cobra18t/CobraPin/README.md

# CobraPin
Pinball Controller based on OPP and designed for use with MPF

Visit https://pinballmakers.com/wiki/index.php?title=CobraPin for more information
