cobra18t/CobraPin/NeoSeg/NeoSeg14x2.PNG

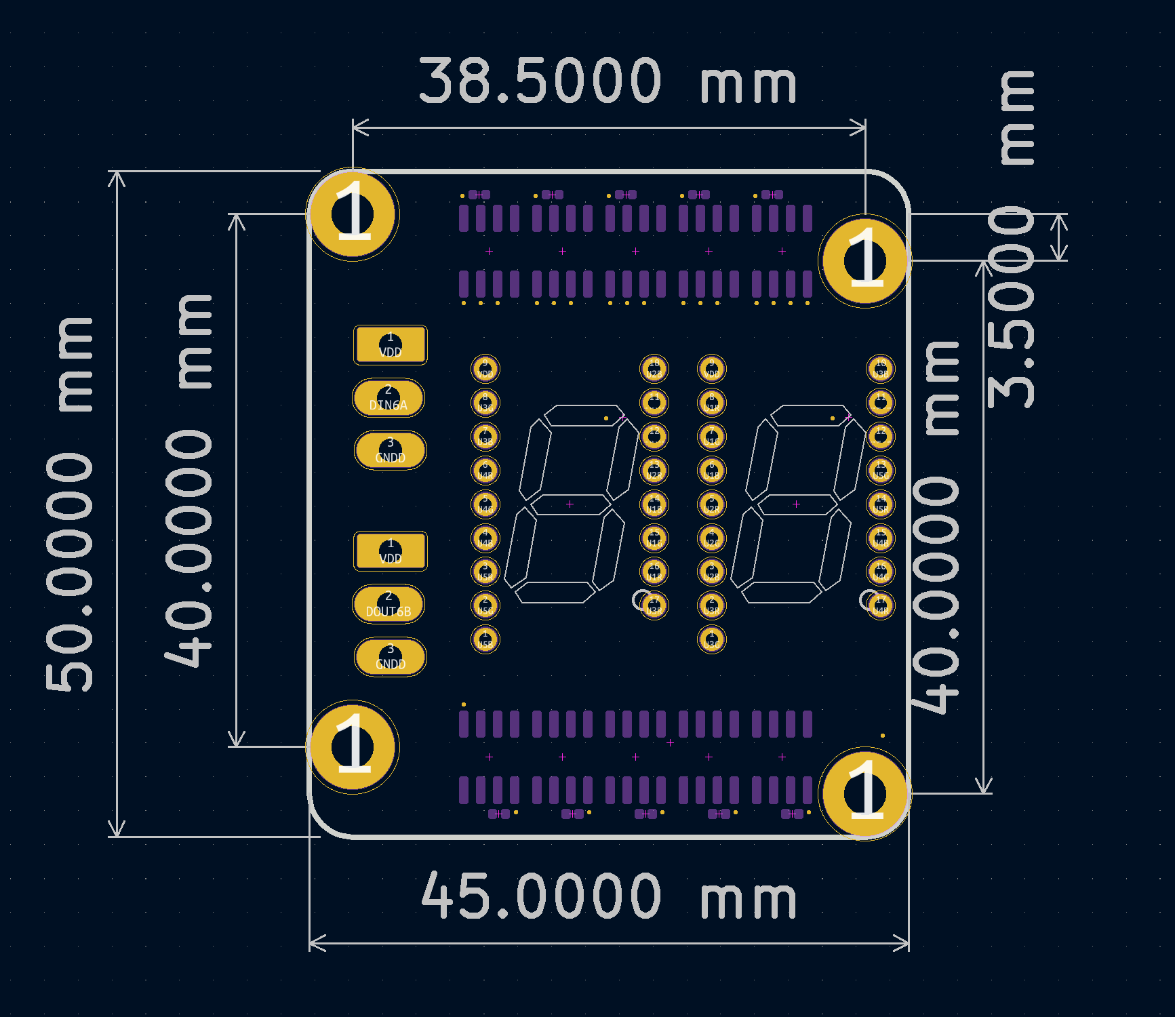
NeoSeg/NeoSeg14x2.PNG
