cobra18t/CobraPin/Games/MiniProto/target.3MF

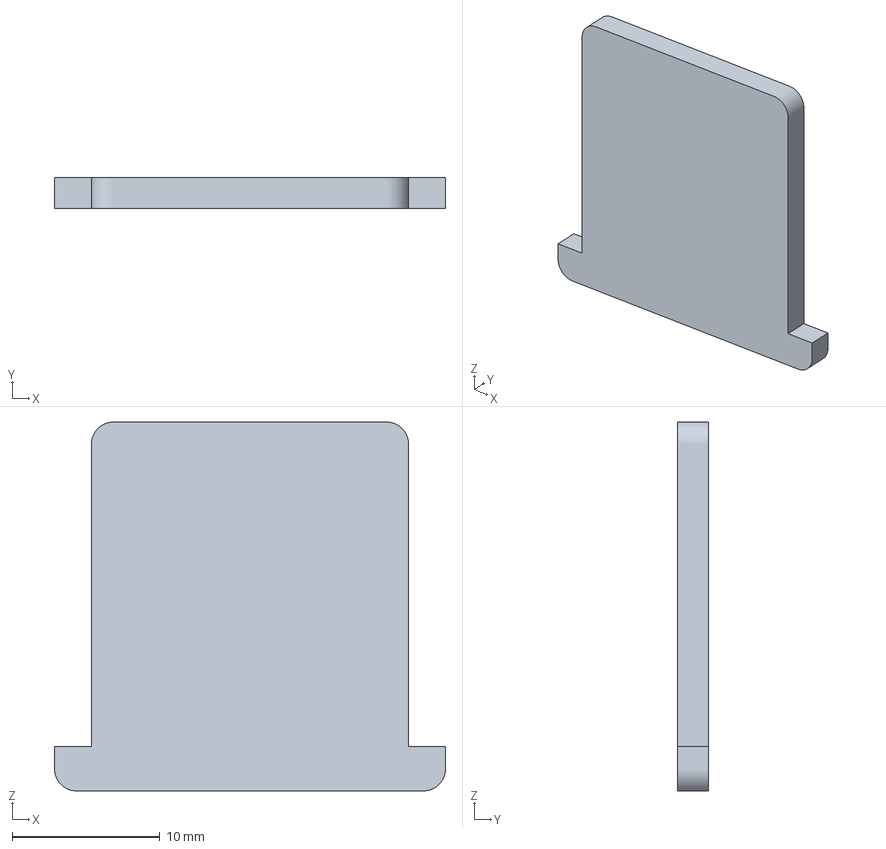
[picture p2: CAD file, 2026-05-30]
Games/MiniProto/target.3MF
26.5 x 2.10 x 25.0 mm
