cobra18t/CobraPin/Games/MiniProto/3bankTarget.3mf

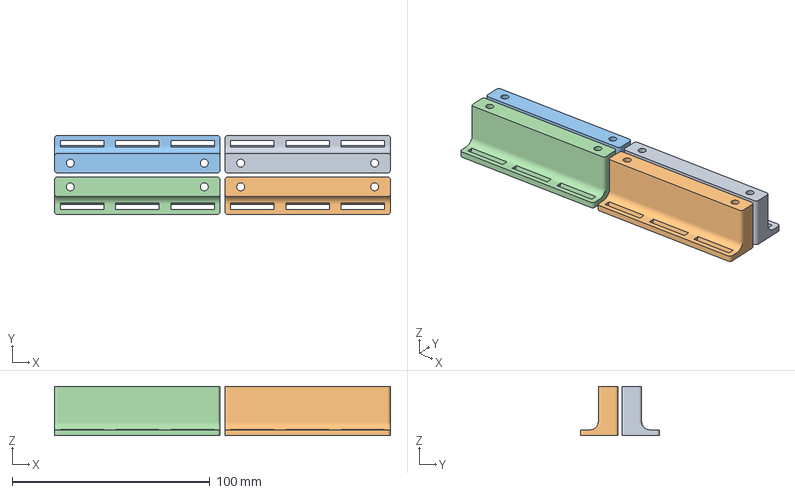
[picture p3: CAD file, 2026-05-30]
Games/MiniProto/3bankTarget.3mf
170.0 x 40.0 x 25.0 mm
3bankTarget x 4
