cobra18t/CobraPin/Games/MiniProto/TallTargetHolder.3MF

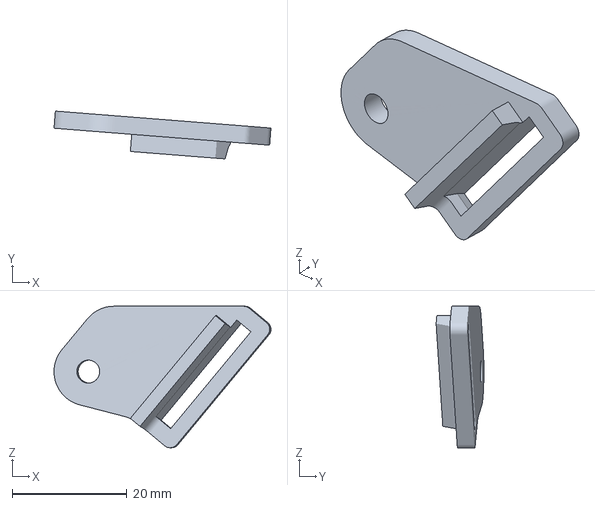
[picture p4: CAD file, 2026-05-30]
Games/MiniProto/TallTargetHolder.3MF
37.9 x 8.35 x 24.7 mm
