cobra18t/CobraPin/Games/MiniProto/drainGuidePickup.3mf

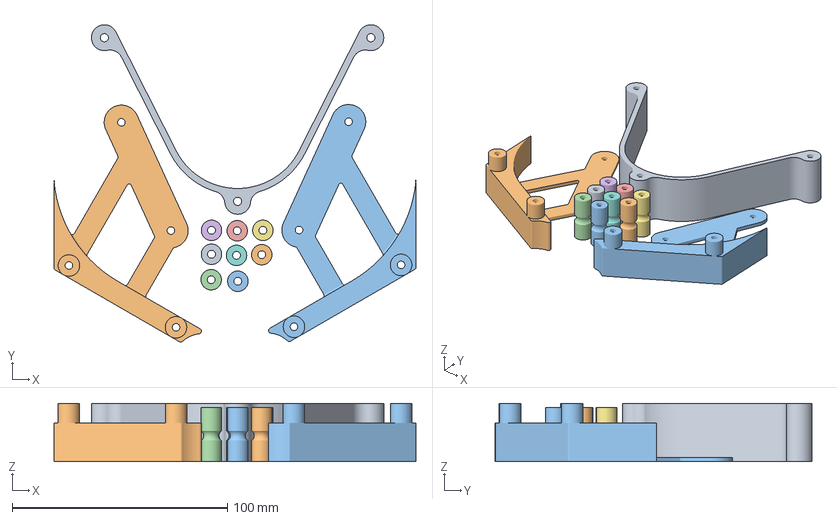
[picture p5: CAD file, 2026-05-30]
Games/MiniProto/drainGuidePickup.3mf
168.1 x 147.4 x 27.0 mm
drainGuidePickup
lower guide x 2
Post x 8
