cobra18t/CobraPin/Games/MiniProto/Post.3MF

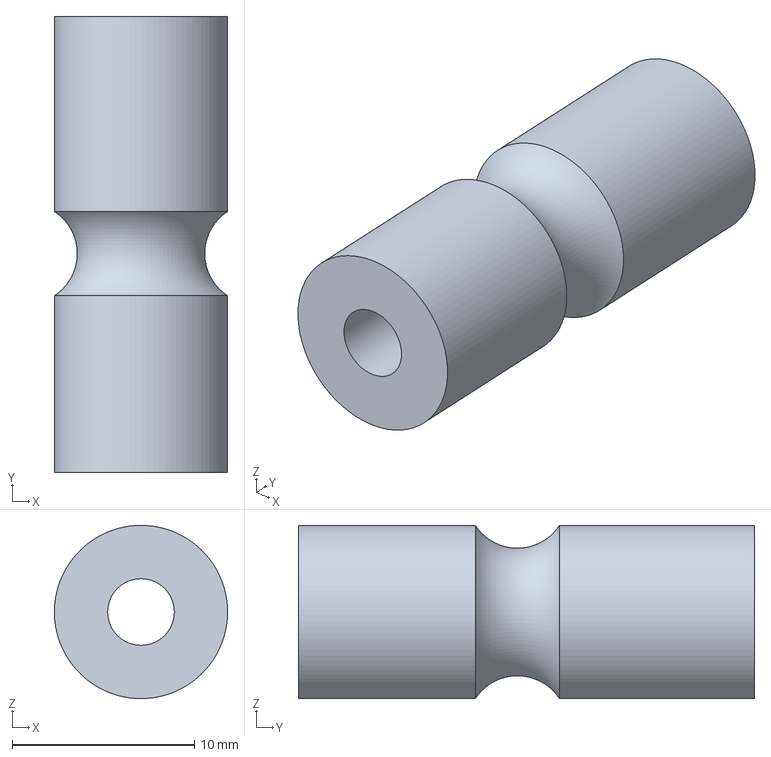
[picture p6: CAD file, 2026-05-30]
Games/MiniProto/Post.3MF
9.49 x 25.0 x 9.50 mm
