cobra18t/CobraPin/Games/MiniProto/targetTaller.3MF

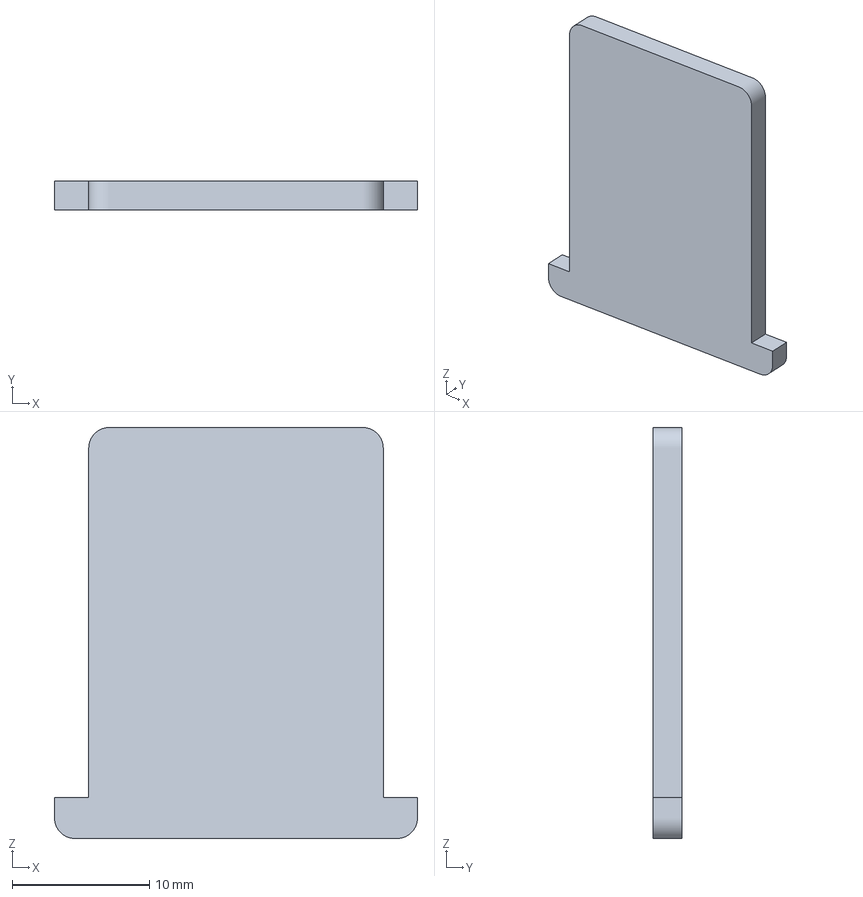
[picture p7: CAD file, 2026-05-30]
Games/MiniProto/targetTaller.3MF
26.5 x 2.10 x 30.0 mm
