cobra18t/CobraPin/Games/MiniProto/orbitAndLoop.3MF

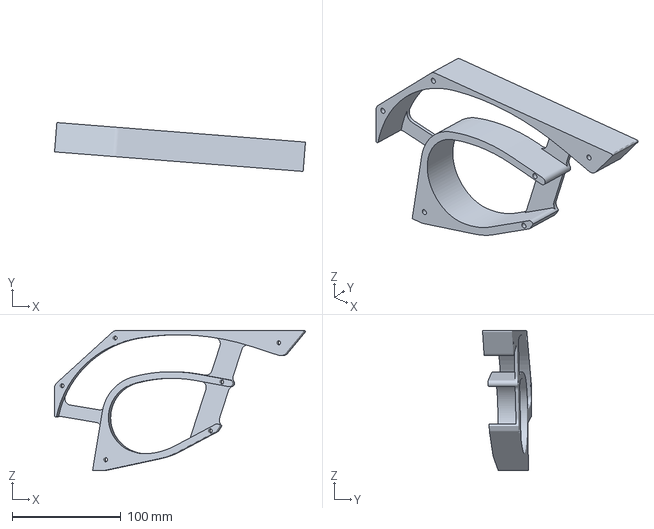
[picture p8: CAD file, 2026-05-30]
Games/MiniProto/orbitAndLoop.3MF
230.3 x 44.9 x 128.6 mm
