cobra18t/CobraPin/Games/MiniProto/MiniProto3_layout.DXF

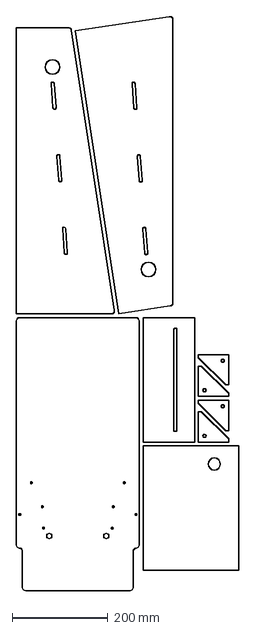
[picture p9: CAD file, 2026-05-30]
Games/MiniProto/MiniProto3_layout.DXF
465.2 x 1202.5 mm
