cobra18t/CobraPin/(threads)

Thread 2 (2022-10-03):

BOM & CPL files for Cobra-pin board

brovreizh, 2022-10-03:
Hello,

I've searched in the documents but I can not find any BOM & CPL files for Cobra-pin, is it normal ? Thx

cobra18t, 2022-10-04:
You can create the BOM and CPL files from the source KiCad files.

Closed 2022-10-04.

Thread 5 (2023-02-13):

Issue with Coil power output

worldpeace-germany, 2023-02-13:
Hi,

on testing flipper fingers some smoke came from the board :-( I would like to understand what went wrong to avoid this mistake in the future. I assume one of the transistors is burned.

Question 1:
The documentation says the max fuse used for the coil power should be 10A. I used one of the 10A fuses. After the issue the fuse is still okay.  Aren't the transistors rated for 10A that they burn? My understanding here is that the fuse should protect the electric components, why is it not?

Question 2:
The output in question (main coil, not hold coil) shows now constantly 24V as output (I am using for my test 24V power supply). Based on that I assume that my transistor is dead for that output. The strange thing is the yellow LED indicating that the transistor is switching is behaving like one for a fully working output. Which means it is off all the time unless I press my trigger button then it is turned on. Either I misunderstood a detail of that yellow LED or the transistor is still okay, but then I should not see constantly 24V on the output. Can that behavior be explained?

Question 3:
At the moment I have no idea how it came to the situation. The  mpf code is basically from the tutorial. So the main coil is only powered for a few ms (default value, I assume 10ms) and the hold coil powered constantly (while keeping the button pressed). The coil is a FL-11629-50V coil, I measured 3.5 Ohm and 135 Ohm of resistance. Which would mean for 24V power supply 6.9A and 170mA. I had a look at https://flippers.com/coil-resistance.html , they say 4/133 Ohm, so no big difference. In the text they say "blue, strongest", the paper wrapping of mine is orange which would be according to their chart a FL-15411 coil with 4.2/150 Ohm. Again no big difference to what I measured. Any idea what mistake I could have made? Would like to avoid killing more outputs....

Thanks!

worldpeace-germany, 2023-02-13:
Okay, found my mistake, I had a short connection on the coil when the switch was pressed. That answers question 3. Question 1 and 2 remain valid. I don't mind too much for now if I have one coil output less, the price you pay when learning new things. Any guess on what I might have fried up?

cobra18t, 2023-02-13:
Re Q1:
The fuses are slow blow fuses. They can actually withstand far more than 10A for a very short amount of time. The transistor can only handle maybe 40A but burns out instantly above that. Since you had a hard short, you had far too much current at once and the transistor burned. It was short enough pulse, though that the fuse survived. I would evaluate your current draws on that bank and consider a lower fuse current. Many people add inline fuses to each flipper.

Re Q2: The yellow LEDs are on the logic side of the FET. They indicate the *Command* to the FET, not the *Output* of the FET. So even though the FET is broken, you can see the command is fine. This enables you to evaluate proper operation on the logic side before applying coil power. I believe your FET is broken.

worldpeace-germany, 2023-02-14:
thanks, understood. then one day I will change the FET.

Closed 2023-02-14.

Thread 6 (2023-04-05):

Seek guidance to size power supply

worldpeace-germany, 2023-04-05:
Hello,

I seek some guidance what is the right size (wattage) of the power supply to choose. I neither want to buy a crazy big power supply, neither it should not have too little wattage that I start buying a second one in half a year.

My considerations are the following:

- Voltage: 48V
- 3 coils in parallel to be fired at max simultaneously (2 flipper fingers plus one sling shot, bumper, etc)
- Coils 26-1200 (10 Ohm), 23-800 ( 4 Ohm) for bumpers, etc.
- FL-11629 (4 Ohm) for flipper fingers

I have no clue yet if the coils for 48V are a good choice, chicken and egg problem. Should be just a "normal" or "average" coil for these purposes.

A 4 Ohm coil would draw 12A, if I have three of them at the same time it is 36A, if the 10 Ohm coil is good for my purpose I have 2*12A + 5A = 29A of electrical current. That would be 1400 - 1800 W - I cannot believe that I need that. Of course current will only be drawn for 20-40ms and we have the large capacitors on the cobra board to buffer. I have no idea how to factor that into my thoughts.

Any guidance, what coils would be good, how to come to a reasonable (and somewhat reliable) result?

About the coils, anything I need to obey that I don't fry a mos-fet on the cobra board?

How powerful are the power supplies of the people reading this?

Thanks!

cobra18t, 2023-04-06:
I have a 48V 7.5A supply. A 10 or 12A would be fine as well. The average load is not actually that high, it is just very spiky. The capacitors help supply those load spikes.

A 4ohm coil should not really draw 12A for even 20-40ms. Remember, the coil acts like an inductor which resists instantaneous changes to current. So if you left the coil on, sure it would get to a 12A draw eventually, but the pulse is over or at least nearly over before then. If you do reach 12A for any appreciable amount of time, you should be blowing fuses.

In the image below, the current never reaches steady state current since the pulse ends before the inductor charges all the way. I have not actually measured the current waveform of these particular coils, though. In the end, a 7.5 to 12A supply "just works" for pinball.

As far as not frying FETs, triple check your pinout and note that each connector has 8 coil outputs but 9 pins. One is a "key" pin that is in a different location on each bank. The key is marked by an asterisk.

Also, coil diodes must always "point" to power. So the cathode must always face the high voltage side. If you get this wrong, you will short 48V to GND through a forward biased diode when you first fire that coil which will surely fry the FET.

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

cobra18t, 2023-04-06:
As far as flipper coils, here is the common guidance:

FL-11753 (Yellow)- Used with short flippers and close shots....think Twilight Zone 2" upper flipper
FL-11722 (Green) - Used for close shots near drop targets...think Twilight Zone 3" upper flipper
FL-11630 (Red) - The standard, most commonly used coil...F-14 main flippers
FL-15411 (Orange) - Used for long playfield shots...Twilight Zone main flippers
FL-11629 (Blue) - Used for long shots and high ramps...Demolition Man main flippers

If you have the latest OPP firmware (2.4.0.0 or later is recommended), you can change the pulse power through MPF to reduce the power of a flipper to tune it. That is what I am doing on my Tag Team.

worldpeace-germany, 2023-04-08:
As usual a perfect answer in no time at all. Thanks very much!

Closed 2023-04-08.

Thread 7 (2023-07-25):

Input Switches min/max resistance

worldpeace-germany, 2023-07-25:
Hi,

a short question, when I want to to use a direct input switch. So far I have closed the switch just by connecting the input pin to GND, so 0 Ohm between input and GND. I assume that internally there is some resistor that it is not a short circuit. So far nothing blew up, can you confirm that this is okay to do?

Now the more important question,  what is the maximum resistance that the the switch is being considered as closed? I assume if I connect the input to GND via 100 Megaohm that this is not recognized as closed. Background of the question is photo diode, if I shine IR light on it, it has a resistance of 180 Ohm. Is that just a limit where it sometimes will work and sometimes not? What is a  safe maximum for a resistor so the switch is reliably considered as closed?

Thanks!

cobra18t, 2023-07-25:
The input pins are pulled up internally with a ~30k ohm resistor, so shorting that to GND is no issue.

A pure resistance analysis of the photodiode is insufficient. Since the matrix is rapidly scanning/pulsing through the columns, capacitance becomes a big player and photodiodes have a fair bit of capacitance.

Are you noticing inconsistencies in the switch performance using the photodiode? When using optos, I usually recommend using the external row pullups on the board to overcome the capacitive effect of the optos. Your photodiode may benefit from the same treatment. https://pinballmakers.com/wiki/index.php?title=CobraPin#Matrix_Row_Pull_Resistor_Jumpers

worldpeace-germany, 2023-07-27:
Hello,

it seems to work, but maybe there is a restriction once I have more switches, whatsoever. It is just a fear I had and would like to be on the right path from the beginning. I saw the note on the pull resistor for the matrix switch, I am using direct input. I have some basic knowledge on electronics (and try to expand), but I am not able to judge if the part is valid as well for direct input switches. Since it was mentioned in the matrix section I decided not to be relevant. If it is, do I need pull up or down?

cobra18t, 2023-07-27:
Ah, direct inputs should be fine. No need for the pull resistors.

Closed 2025-06-28.

Thread 8 (2025-06-27):

Kicad files for Xpansion board

VLanvin, 2025-06-27:
Hey there!

Any chance you could add the kicad files for the Xpansion board? I'd like to drive both neopixels and 12V lights.

Thanks!

cobra18t, 2025-06-28:
Source added to the KiCad folder. The Xpansion board does not drive Neopixels, just to be clear. The lamp supply voltage should be around 18V for normal pinball bulbs (https://pinballmakers.com/wiki/index.php?title=CobraPin#Power_Input_2).

Closed 2025-06-28.
