cobra18t/CobraPin/KiCad/CobraPin_Xpansion.pdf

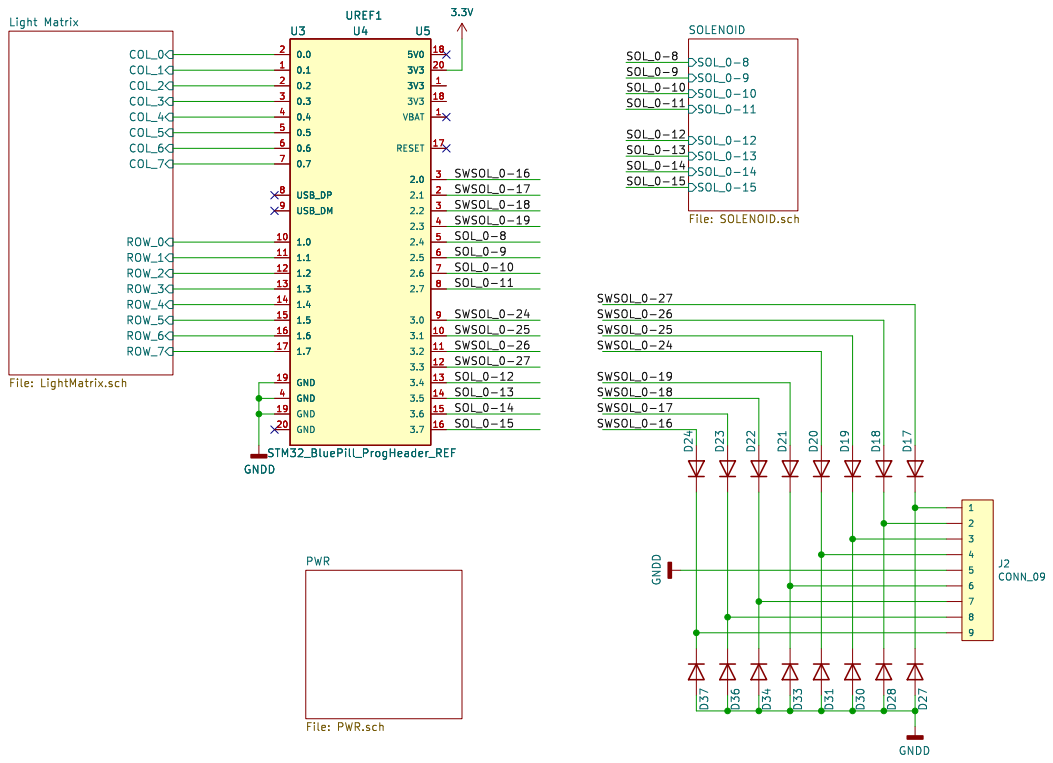
[picture p10: page 1]

Id: 1/4 Title: File: CobraPin_Xpansion.sch Sheet: / PWR

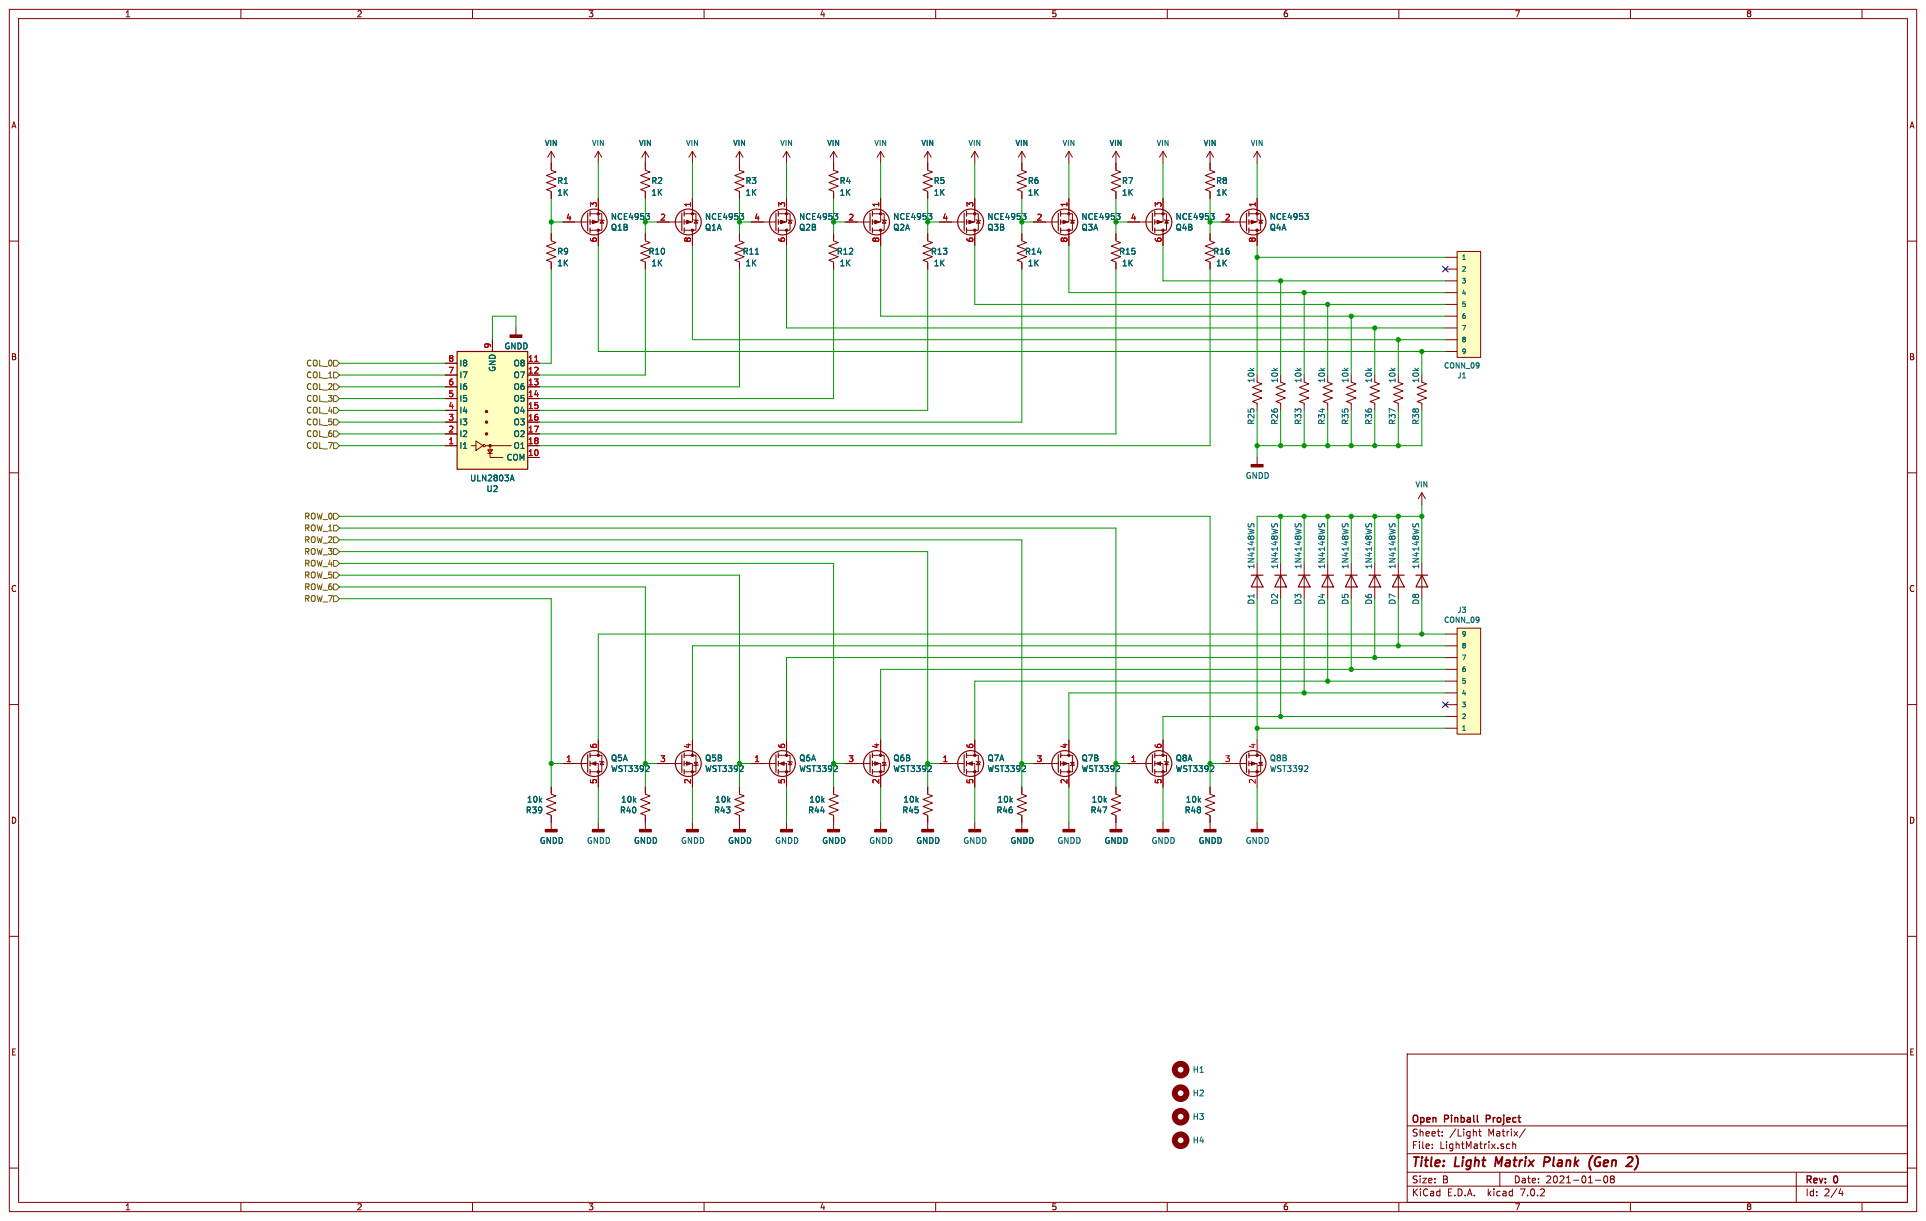
[picture p11: page 2]

5 6 Q7A WST3392 GNDD GNDD GNDD GNDD

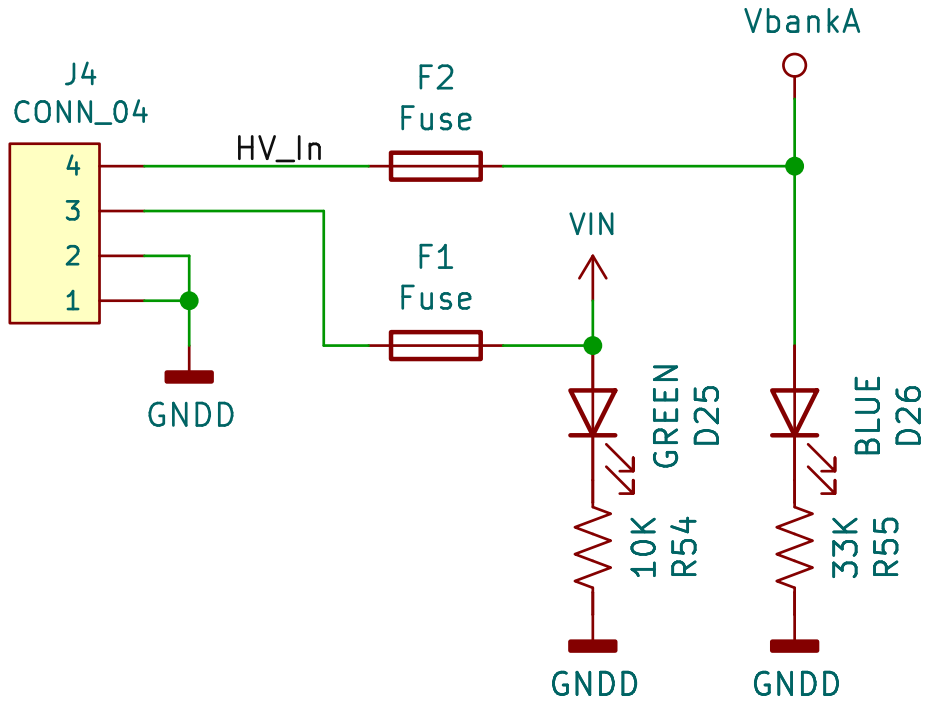
[picture p12: page 3]

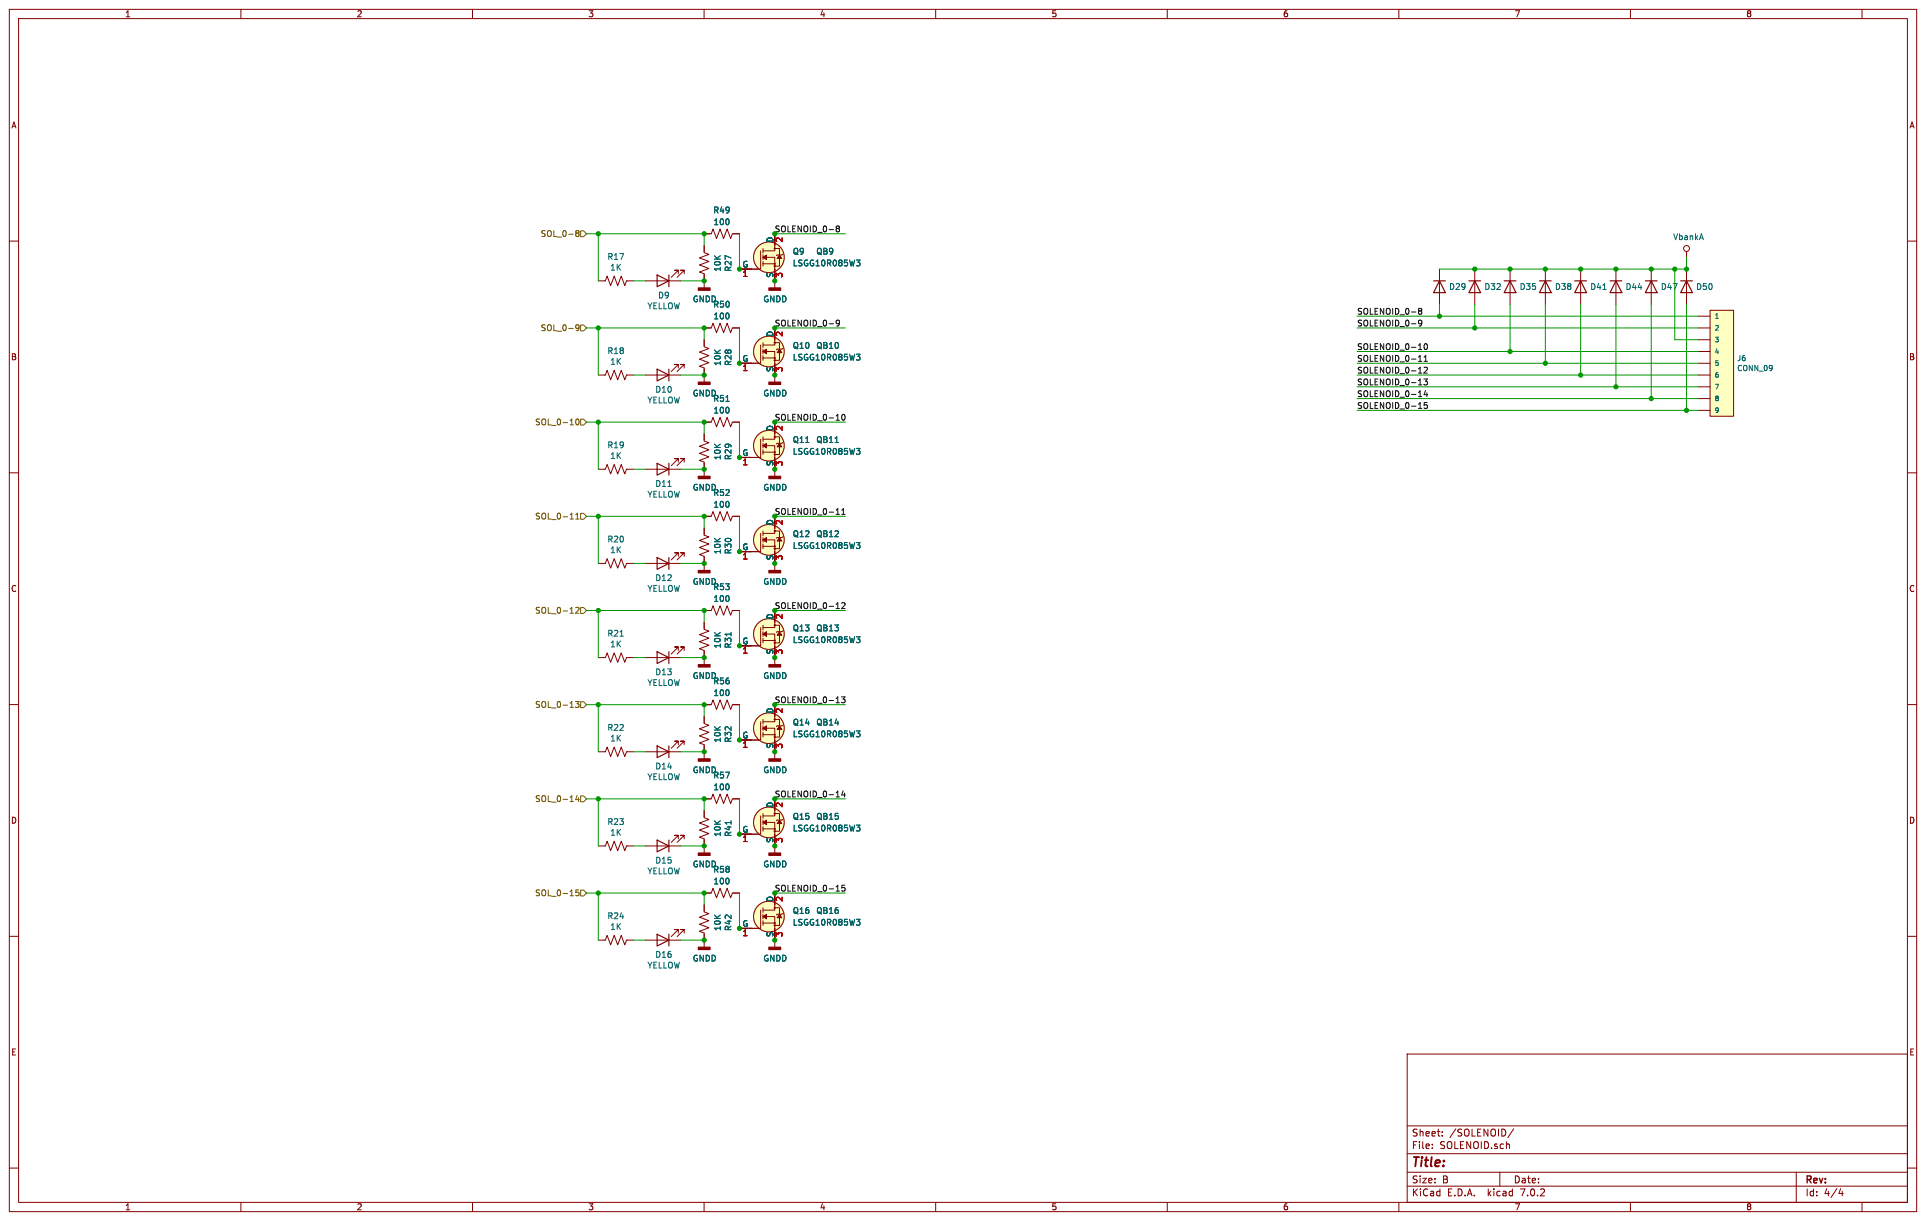
[picture p13: page 4]

Id: 4/4 Title: File: SOLENOID.sch Sheet: /SOLENOID/
