cobra18t/CobraPin/KiCad/CobraPin_v1_03.pdf

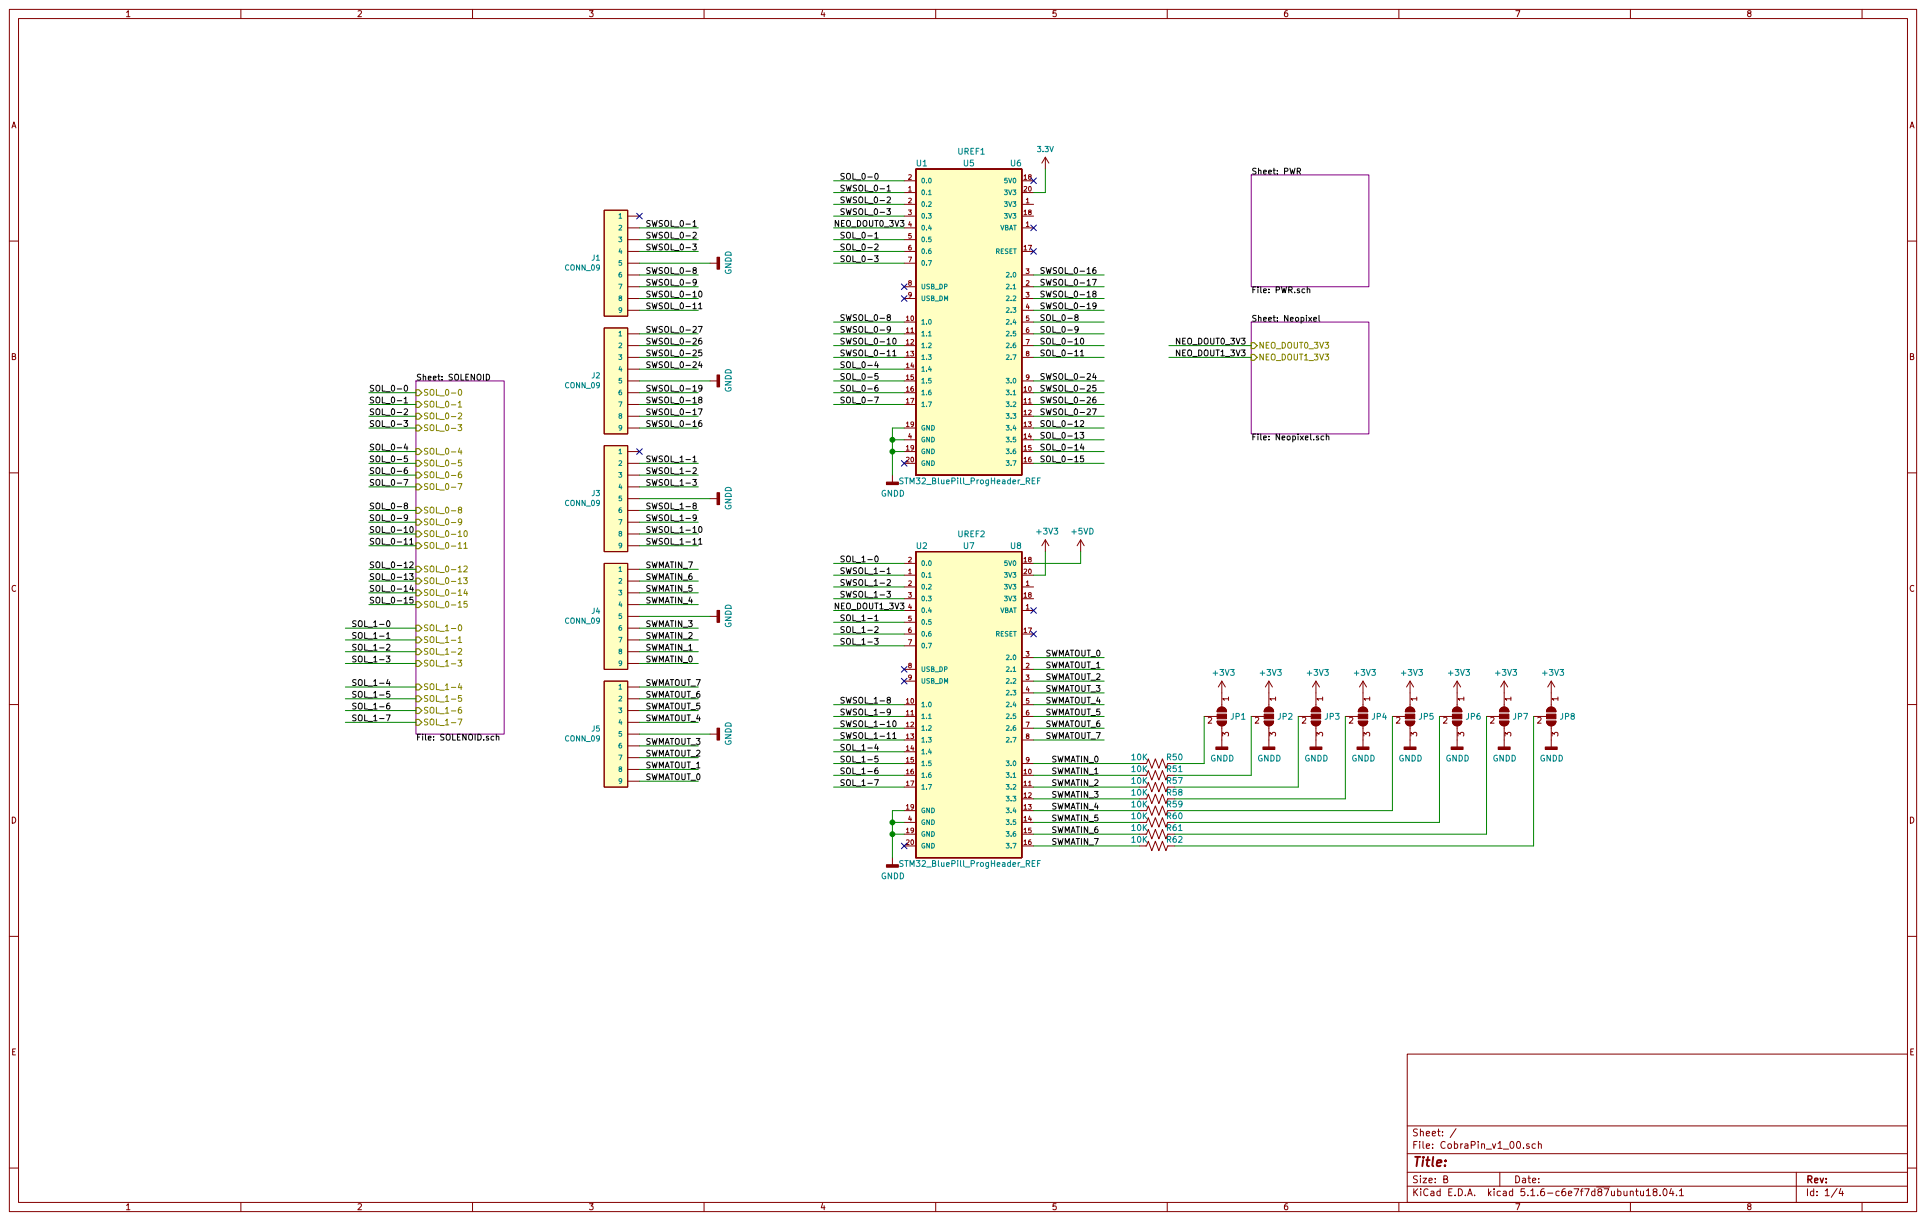
[picture p14: page 1]

File: PWR.sch Sheet: Neopixel

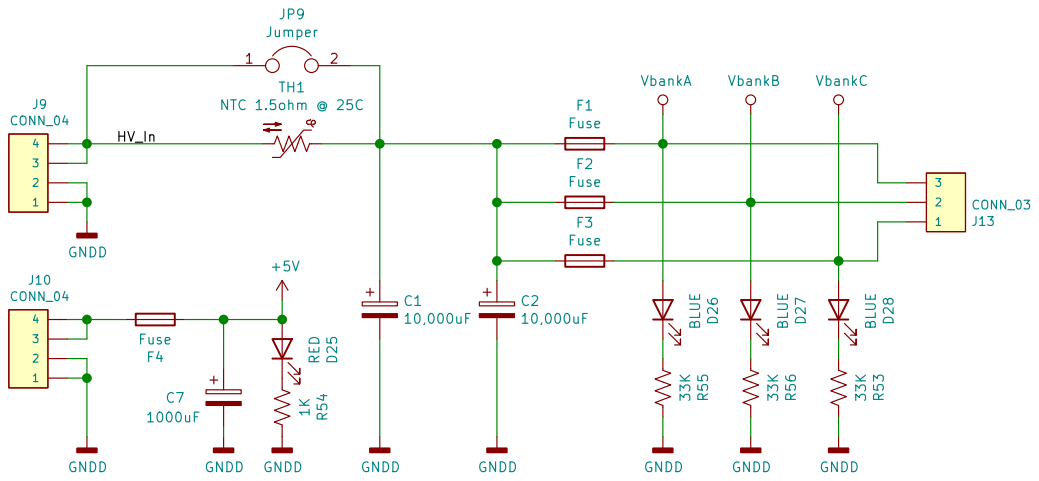
[picture p15: page 2]

Id: 2/4 Title: File: PWR.sch Sheet: /PWR/ D28 BLUE

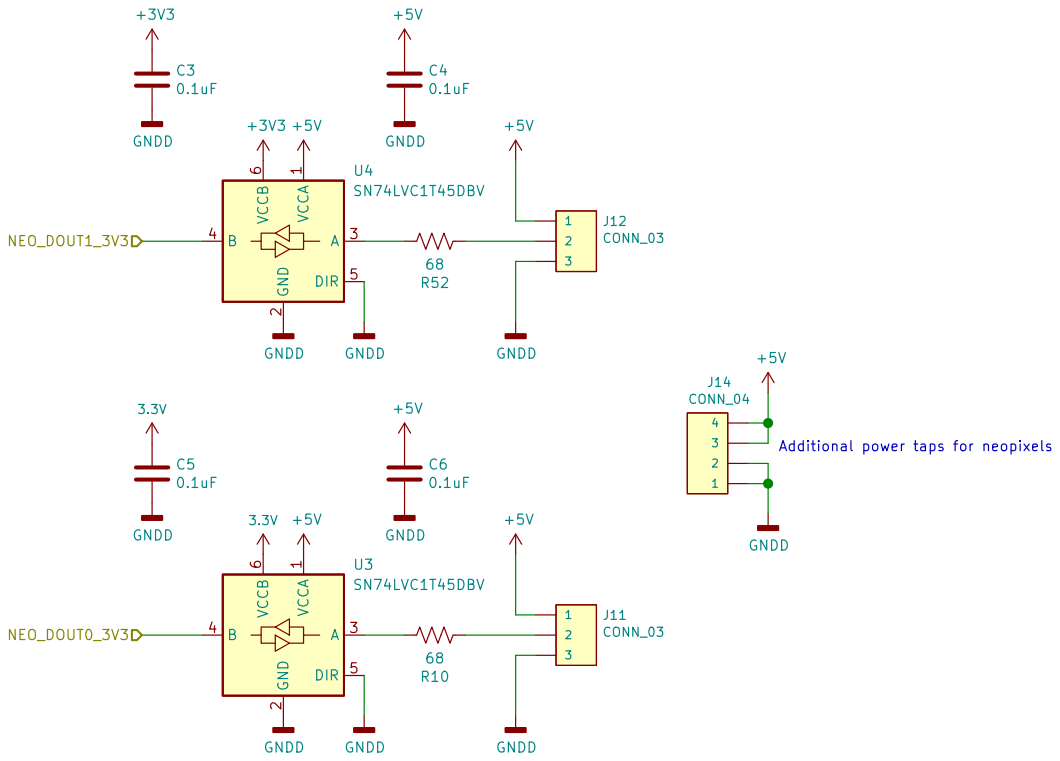
[picture p16: page 3]

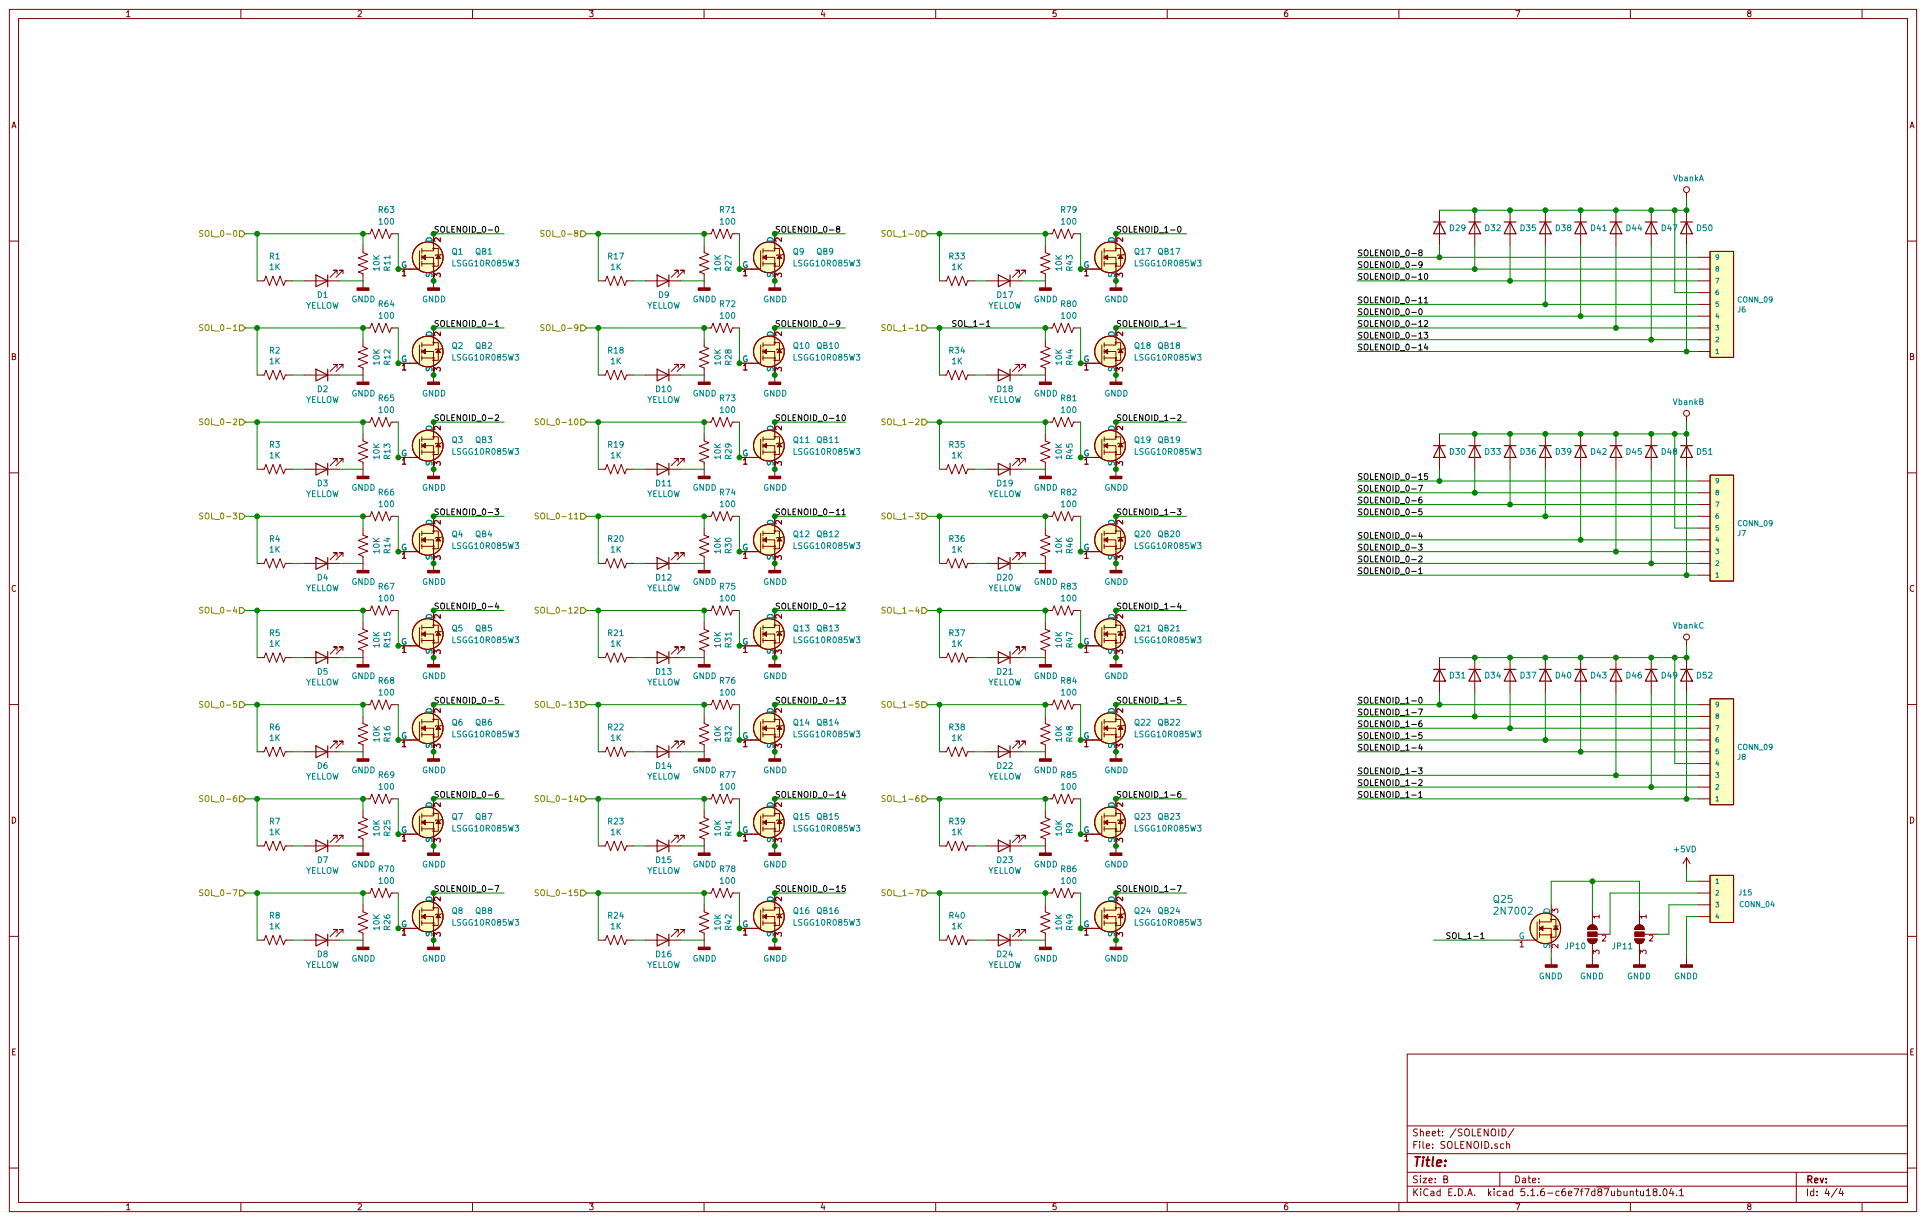
[picture p17: page 4]

Id: 4/4 Title: File: SOLENOID.sch Sheet: /SOLENOID/
