cobra18t/CobraPin/Errata/CobraPin J4_J5 Relabel.pdf

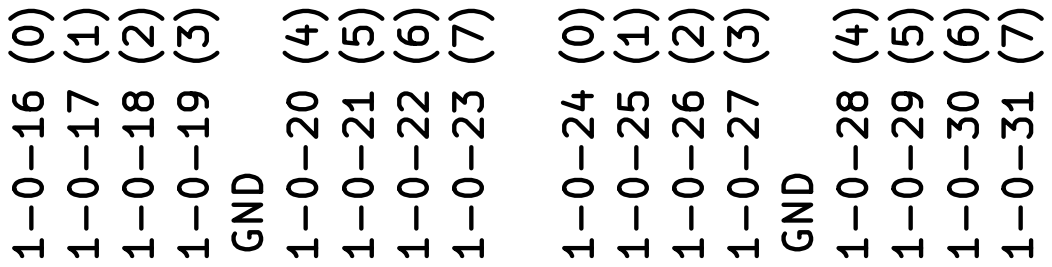
[picture p18: page 1]
