cobra18t/CobraPin/KiCad/Satellite_boardDimensions.pdf

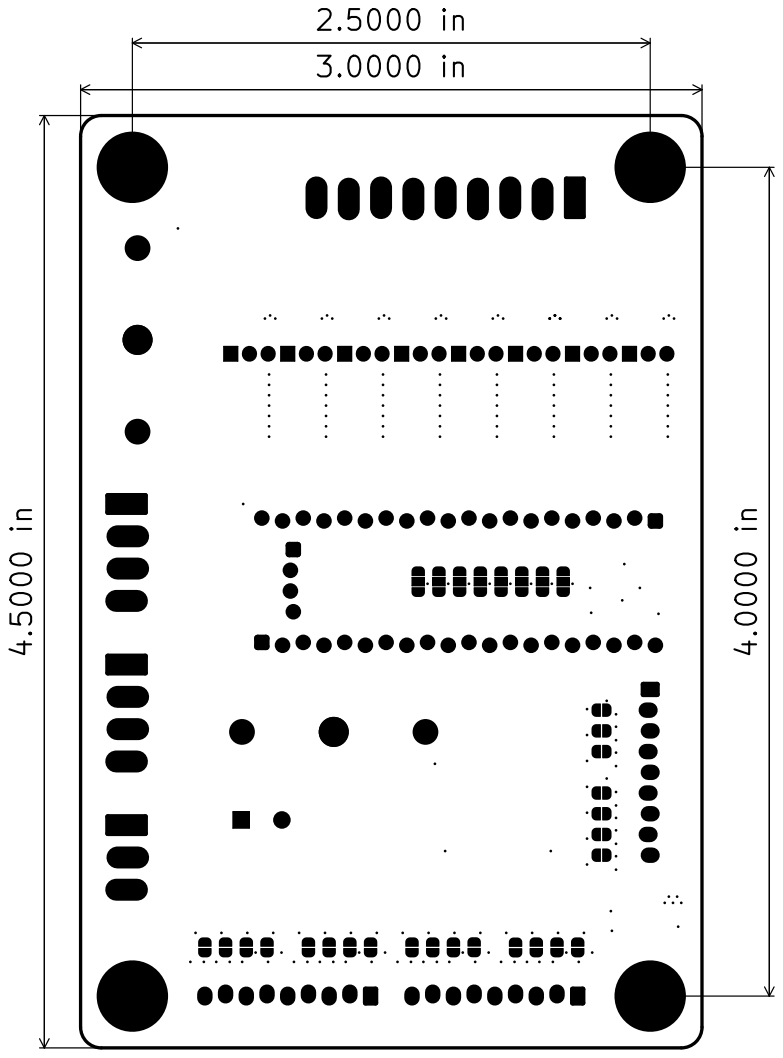
[picture p19: page 1]
