cobra18t/CobraPin/NeoSeg/NeoSeg14 8-Digit.pdf

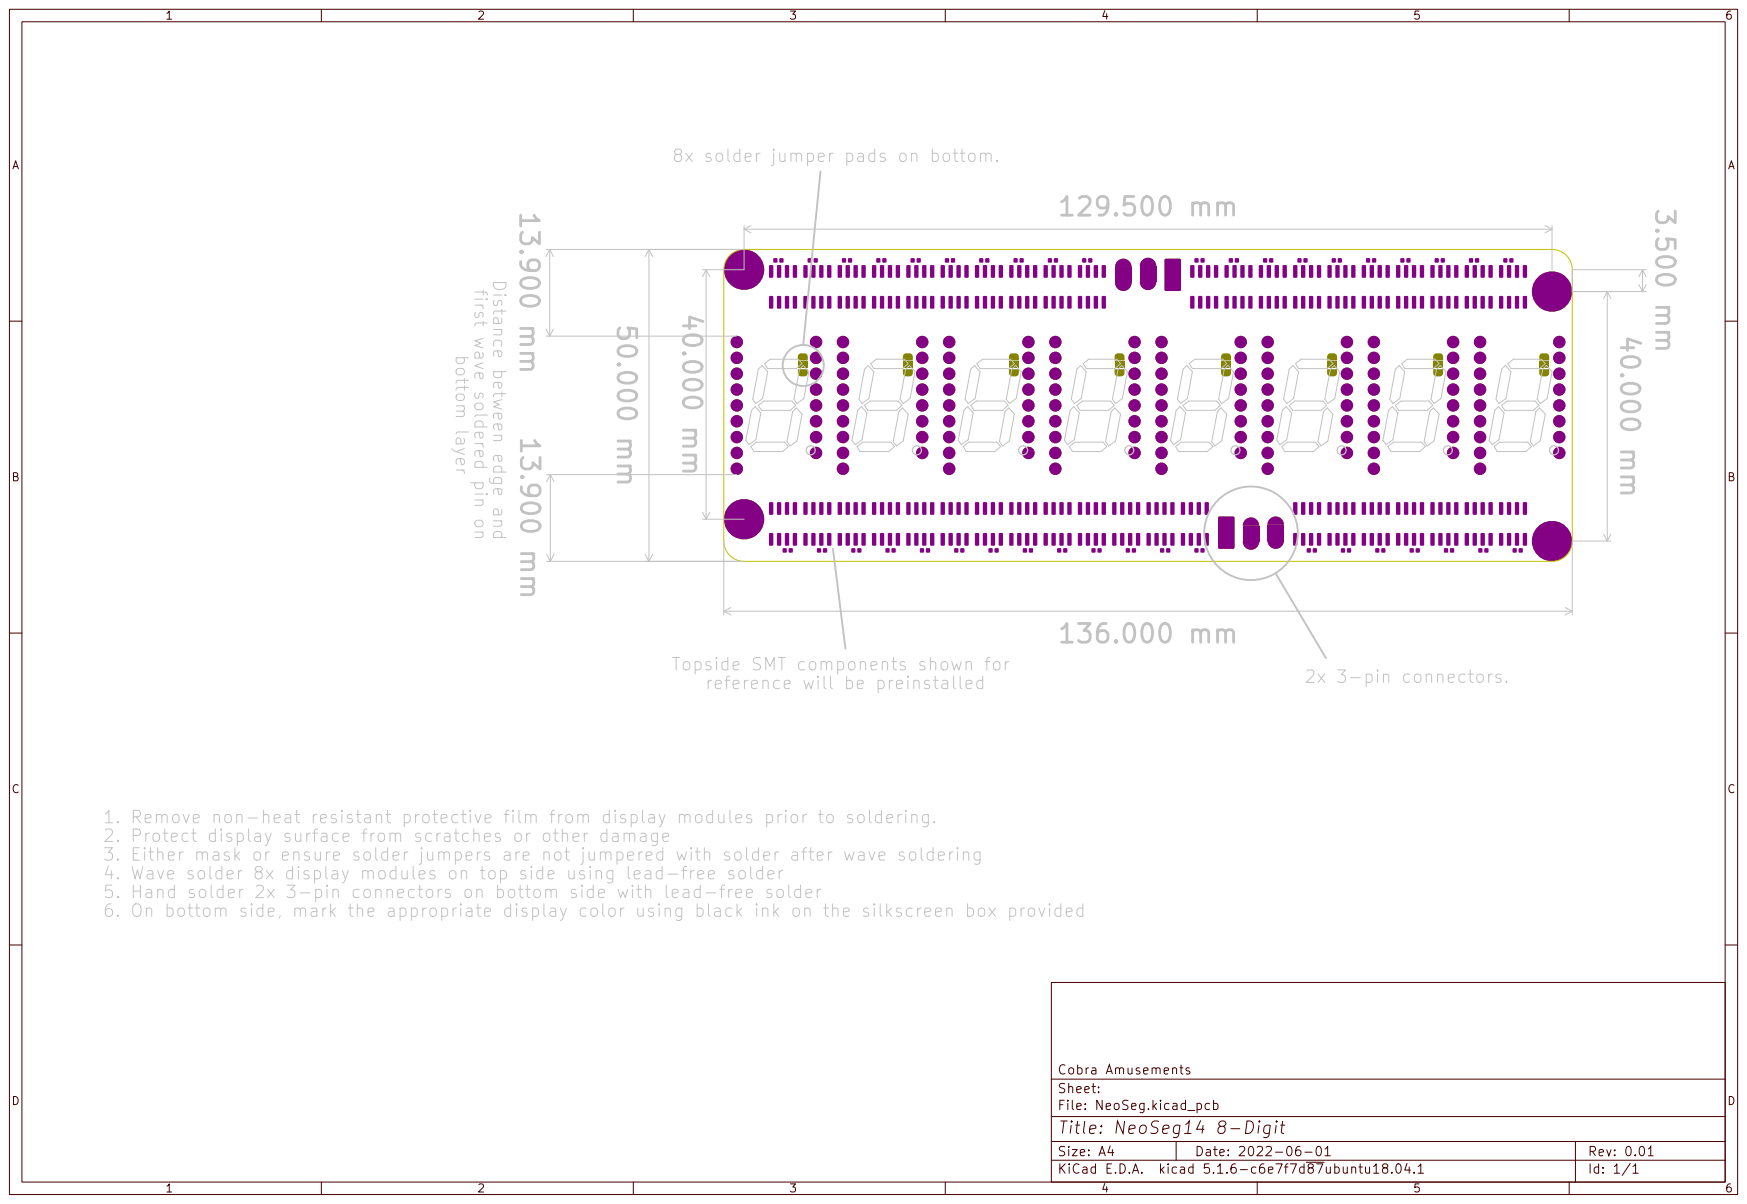
[picture p20: page 1]
