cobra18t/CobraPin/KiCad/CobraPin_v1_00.kicad_pcb

## KiCad design KiCad/CobraPin_v1_00.kicad_pcb (2021-08-28)

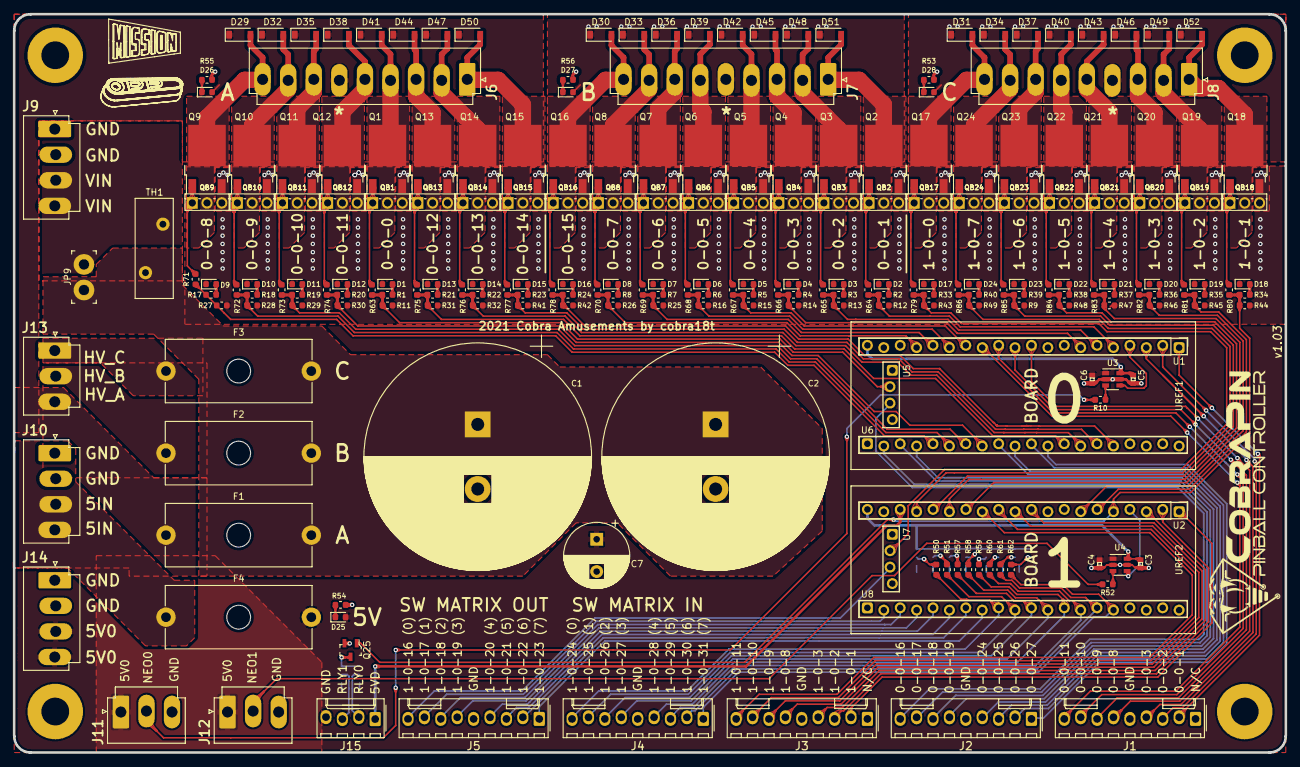
[picture p21: board CobraPin_v1_00.kicad_pcb from above]

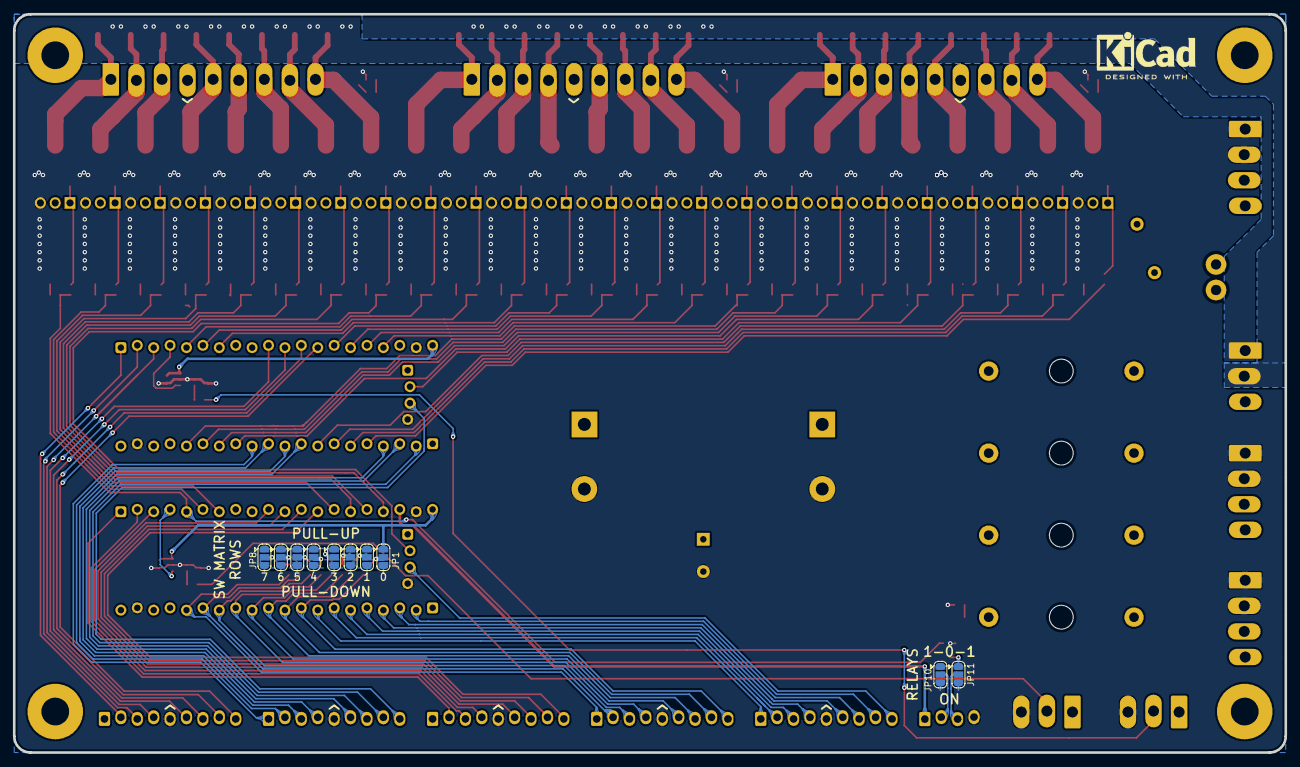
[picture p22: board CobraPin_v1_00.kicad_pcb from below]

Board: 2 copper layers, 196.9 x 114.3 mm, 235 parts (10 on the bottom side), 166 nets.

Parts:
C1, C2: 10,000uF; CP_Radial_D35.0mm_P10.00mm_SnapIn
C3, C4, C5, C6: 0.1uF; 0402
C7: 1000uF; CP_Radial_D10.0mm_P5.00mm
D1, D2, D3, D4, D5, D6, D7, D8, D9, D10, D11, D12, D13, D14, D15, D16, D17, D18, D19, D20, D21, D22, D23, D24: YELLOW; LED_0603_1608Metric
D25: RED; LED_0603_1608Metric
D26, D27, D28: BLUE; LED_0603_1608Metric
D29, D30, D31, D32, D33, D34, D35, D36, D37, D38, D39, D40, D41, D42, D43, D44, D45, D46, D47, D48, D49, D50, D51, D52: 1A 1000V; D_SOD-123
F1, F2, F3, F4: Fuse; Fuseholder_Cylinder-5x20mm_Schurter_0031_8201_Horizontal_Op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
J1, J2, J3, J4, J5: CONN_09; Molex_KK-254_AE-6410-09A_1x09_P2.54mm_Vertical_Lock
J6, J7, J8: CONN_09; JST_VH_B9P-VH_1x09_P3.96mm_Vertical_LongPads_Lock
J9, J10, J14: CONN_04; JST_VH_B4P-VH_1x04_P3.96mm_Vertical_LongPads_Lock
J11, J12, J13: CONN_03; JST_VH_B3P-VH_1x03_P3.96mm_Vertical_LongPads_Lock
J15: CONN_04; Molex_KK-254_AE-6410-09A_1x04_P2.54mm_Vertical_Lock
JP1, JP2, JP3, JP4, JP5, JP6, JP7, JP8, JP10, JP11: SolderJumper_3_Open; SolderJumper-3_P1.3mm_Open_RoundedPad1.0x1.5mm
JP9: Jumper; PinHeader_1x2_P3.96mm_Drill1.6mm_TEF
Q1, Q2, Q3, Q4, Q5, Q6, Q7, Q8, Q9, Q10, Q11, Q12, Q13, Q14, Q15, Q16, Q17, Q18, Q19, Q20, Q21, Q22, Q23, Q24: LSGG10R085W3; TO-252-2
Q25: 2N7002; SOT-23-3
QB1, QB2, QB3, QB4, QB5, QB6, QB7, QB8, QB9, QB10, QB11, QB12, QB13, QB14, QB15, QB16, QB17, QB18, QB19, QB20, QB21, QB22, QB23, QB24: TO251; TO-251-3_Vertical
R1, R2, R3, R4, R5, R6, R7, R8, R17, R18, R19, R20, R21, R22, R23, R24, R33, R34, R35, R36, R37, R38, R39, R40, R54: 1K; R_0603_1608Metric
R9, R11, R12, R13, R14, R15, R16, R25, R26, R27, R28, R29, R30, R31, R32, R41, R42, R43, R44, R45, R46, R47, R48, R49, R50, R51, R57, R58, R59, R60, R61, R62: 10K; R_0603_1608Metric
R10, R52: 68; R_0603_1608Metric
R53, R55, R56: 33K; R_0603_1608Metric
R63, R64, R65, R66, R67, R68, R69, R70, R71, R72, R73, R74, R75, R76, R77, R78, R79, R80, R81, R82, R83, R84, R85, R86: 100; R_0603_1608Metric
TH1: NTC 1.5ohm @ 25C; RV_Disc_D15.5mm_W5.9mm_P7.5mm_TEF
U1, U2: STM32_BluePill_ProgHeader_Separate_A; 1x20_FEMALE_LOCK
U3, U4: SN74LVC1T45DBV; SOT-23-6
U5, U7: STM32_BluePill_ProgHeader_Separate_B; 1x04_FEMALE_LOCK
U6, U8: STM32_BluePill_ProgHeader_Separate_C; 1x20_FEMALE_LOCK
UREF1, UREF2: STM32_BluePill_ProgHeader_REF

Connections:
3.3V: C5.1, U1.20, U3.6
+3V3: C3.1, JP1.1, JP2.1, JP3.1, JP4.1, JP5.1, JP6.1, JP7.1, JP8.1, U2.20, U4.6
+5V: C4.1, C6.1, C7.1, D25.2, F4.2, J11.1, J12.1, J14.3, J14.4, U3.1, U4.1
+5VD: J15.1, U2.18
/NEO_DOUT0_3V3: U1.4, U3.4
/NEO_DOUT1_3V3: U2.4, U4.4
/PWR/HV_In: J9.3, J9.4, JP9.1, TH1.2
/SOLENOID/SOLENOID_0-0: D41.2, J6.4, Q1.2, QB1.2
/SOLENOID/SOLENOID_0-1: D51.2, J7.1, Q2.2, QB2.2
/SOLENOID/SOLENOID_0-2: D48.2, J7.2, Q3.2, QB3.2
/SOLENOID/SOLENOID_0-3: D45.2, J7.3, Q4.2, QB4.2
/SOLENOID/SOLENOID_0-4: D42.2, J7.4, Q5.2, QB5.2
/SOLENOID/SOLENOID_0-5: D39.2, J7.6, Q6.2, QB6.2
/SOLENOID/SOLENOID_0-6: D36.2, J7.7, Q7.2, QB7.2
/SOLENOID/SOLENOID_0-7: D33.2, J7.8, Q8.2, QB8.2
/SOLENOID/SOLENOID_0-8: D29.2, J6.9, Q9.2, QB9.2
/SOLENOID/SOLENOID_0-9: D32.2, J6.8, Q10.2, QB10.2
/SOLENOID/SOLENOID_0-10: D35.2, J6.7, Q11.2, QB11.2
/SOLENOID/SOLENOID_0-11: D38.2, J6.5, Q12.2, QB12.2
/SOLENOID/SOLENOID_0-12: D44.2, J6.3, Q13.2, QB13.2
/SOLENOID/SOLENOID_0-13: D47.2, J6.2, Q14.2, QB14.2
/SOLENOID/SOLENOID_0-14: D50.2, J6.1, Q15.2, QB15.2
/SOLENOID/SOLENOID_0-15: D30.2, J7.9, Q16.2, QB16.2
/SOLENOID/SOLENOID_1-0: D31.2, J8.9, Q17.2, QB17.2
/SOLENOID/SOLENOID_1-1: D52.2, J8.1, Q18.2, QB18.2
/SOLENOID/SOLENOID_1-2: D49.2, J8.2, Q19.2, QB19.2
/SOLENOID/SOLENOID_1-3: D46.2, J8.3, Q20.2, QB20.2
/SOLENOID/SOLENOID_1-4: D43.2, J8.5, Q21.2, QB21.2
/SOLENOID/SOLENOID_1-5: D40.2, J8.6, Q22.2, QB22.2
/SOLENOID/SOLENOID_1-6: D37.2, J8.7, Q23.2, QB23.2
/SOLENOID/SOLENOID_1-7: D34.2, J8.8, Q24.2, QB24.2
/SOL_0-0: R1.1, R11.1, R63.1, U5.2
/SOL_0-1: R2.1, R12.1, R64.1, U1.5
/SOL_0-2: R3.1, R13.1, R65.1, U1.6
/SOL_0-3: R4.1, R14.1, R66.1, U1.7
/SOL_0-4: R5.1, R15.1, R67.1, U1.14
/SOL_0-5: R6.1, R16.1, R68.1, U1.15
/SOL_0-6: R7.1, R25.1, R69.1, U1.16
/SOL_0-7: R8.1, R26.1, R70.1, U1.17
/SOL_0-8: R17.1, R27.1, R71.1, U6.5
/SOL_0-9: R18.1, R28.1, R72.1, U6.6
/SOL_0-10: R19.1, R29.1, R73.1, U6.7
/SOL_0-11: R20.1, R30.1, R74.1, U6.8
/SOL_0-12: R21.1, R31.1, R75.1, U6.13
/SOL_0-13: R22.1, R32.1, R76.1, U6.14
/SOL_0-14: R23.1, R41.1, R77.1, U6.15
/SOL_0-15: R24.1, R42.1, R78.1, U6.16
/SOL_1-0: R33.1, R43.1, R79.1, U7.2
/SOL_1-1: Q25.1, R34.1, R44.1, R80.1, U2.5
/SOL_1-2: R35.1, R45.1, R81.1, U2.6
/SOL_1-3: R36.1, R46.1, R82.1, U2.7
/SOL_1-4: R37.1, R47.1, R83.1, U2.14
/SOL_1-5: R38.1, R48.1, R84.1, U2.15
/SOL_1-6: R9.1, R39.1, R85.1, U2.16
/SOL_1-7: R40.1, R49.1, R86.1, U2.17
/SWMATIN_0: J4.9, R50.1, U8.9
/SWMATIN_1: J4.8, R51.1, U8.10
/SWMATIN_2: J4.7, R57.1, U8.11
/SWMATIN_3: J4.6, R58.1, U8.12
/SWMATIN_4: J4.4, R59.1, U8.13
/SWMATIN_5: J4.3, R60.1, U8.14
/SWMATIN_6: J4.2, R61.1, U8.15
/SWMATIN_7: J4.1, R62.1, U8.16
/SWMATOUT_0: J5.9, U7.3
/SWMATOUT_1: J5.8, U8.2
/SWMATOUT_2: J5.7, U8.3
/SWMATOUT_3: J5.6, U8.4
/SWMATOUT_4: J5.4, U8.5
/SWMATOUT_5: J5.3, U8.6
/SWMATOUT_6: J5.2, U8.7
/SWMATOUT_7: J5.1, U8.8
/SWSOL_0-1: J1.2, U1.1
/SWSOL_0-2: J1.3, U1.2
/SWSOL_0-3: J1.4, U1.3
/SWSOL_0-8: J1.6, U1.10
/SWSOL_0-9: J1.7, U1.11
/SWSOL_0-10: J1.8, U1.12
/SWSOL_0-11: J1.9, U1.13
/SWSOL_0-16: J2.9, U5.3
/SWSOL_0-17: J2.8, U6.2
/SWSOL_0-18: J2.7, U6.3
/SWSOL_0-19: J2.6, U6.4
/SWSOL_0-24: J2.4, U6.9
/SWSOL_0-25: J2.3, U6.10
/SWSOL_0-26: J2.2, U6.11
/SWSOL_0-27: J2.1, U6.12
/SWSOL_1-1: J3.2, U2.1
/SWSOL_1-2: J3.3, U2.2
/SWSOL_1-3: J3.4, U2.3
/SWSOL_1-8: J3.6, U2.10
/SWSOL_1-9: J3.7, U2.11
/SWSOL_1-10: J3.8, U2.12
/SWSOL_1-11: J3.9, U2.13
GNDD: C1.2, C2.2, C3.2, C4.2, C5.2, C6.2, C7.2, D1.1, D2.1, D3.1, D4.1, D5.1, D6.1, D7.1, D8.1, D9.1, D10.1, D11.1, D12.1, D13.1, D14.1, D15.1, D16.1, D17.1, D18.1, D19.1, D20.1, D21.1, D22.1, D23.1, D24.1, J1.5, J2.5, J3.5, J4.5, J5.5, J9.1, J9.2, J10.1, J10.2, J11.3, J12.3, J14.1, J14.2, J15.4, JP1.3, JP2.3, JP3.3, JP4.3, JP5.3, JP6.3, JP7.3, JP8.3, JP10.3, JP11.3, Q1.3, Q2.3, Q3.3, Q4.3, Q5.3, Q6.3, Q7.3, Q8.3, Q9.3, Q10.3, Q11.3, Q12.3, Q13.3, Q14.3, Q15.3, Q16.3, Q17.3, Q18.3, Q19.3, Q20.3, Q21.3, Q22.3, Q23.3, Q24.3, Q25.2, QB1.3, QB2.3, QB3.3, QB4.3, QB5.3, QB6.3, QB7.3, QB8.3, QB9.3, QB10.3, QB11.3, QB12.3, QB13.3, QB14.3, QB15.3, QB16.3, QB17.3, QB18.3, QB19.3, QB20.3, QB21.3, QB22.3, QB23.3, QB24.3, R9.2, R11.2, R12.2, R13.2, R14.2, R15.2, R16.2, R25.2, R26.2, R27.2, R28.2, R29.2, R30.2, R31.2, R32.2, R41.2, R42.2, R43.2, R44.2, R45.2, R46.2, R47.2, R48.2, R49.2, R53.2, R54.2, R55.2, R56.2, U1.19, U2.19, U3.2, U3.5, U4.2, U4.5, U5.4, U6.19, U7.4, U8.19
unnamed: C1.1, C2.1, F1.2, F2.2, F3.2, JP9.2, TH1.1
unnamed: D1.2, R1.2
unnamed: D2.2, R2.2
unnamed: D3.2, R3.2
unnamed: D4.2, R4.2
unnamed: D5.2, R5.2
unnamed: D6.2, R6.2
unnamed: D7.2, R7.2
unnamed: D8.2, R8.2
unnamed: D9.2, R17.2
unnamed: D10.2, R18.2
unnamed: D11.2, R19.2
unnamed: D12.2, R20.2
unnamed: D13.2, R21.2
unnamed: D14.2, R22.2
unnamed: D15.2, R23.2
unnamed: D16.2, R24.2
unnamed: D17.2, R33.2
unnamed: D18.2, R34.2
unnamed: D19.2, R35.2
unnamed: D20.2, R36.2
unnamed: D21.2, R37.2
unnamed: D22.2, R38.2
unnamed: D23.2, R39.2
unnamed: D24.2, R40.2
unnamed: D25.1, R54.1
unnamed: D26.1, R55.1
unnamed: D27.1, R56.1
unnamed: D28.1, R53.1
unnamed: F4.1, J10.3, J10.4
unnamed: J11.2, R10.1
unnamed: J12.2, R52.1
unnamed: J15.2, JP10.2
unnamed: J15.3, JP11.2
unnamed: JP1.2, R50.2
unnamed: JP2.2, R51.2
unnamed: JP3.2, R57.2
unnamed: JP4.2, R58.2
unnamed: JP5.2, R59.2
unnamed: JP6.2, R60.2
unnamed: JP7.2, R61.2
unnamed: JP8.2, R62.2
unnamed: JP10.1, JP11.1, Q25.3
unnamed: Q1.1, QB1.1, R63.2
unnamed: Q2.1, QB2.1, R64.2
unnamed: Q3.1, QB3.1, R65.2
unnamed: Q4.1, QB4.1, R66.2
unnamed: Q5.1, QB5.1, R67.2
unnamed: Q6.1, QB6.1, R68.2
unnamed: Q7.1, QB7.1, R69.2
unnamed: Q8.1, QB8.1, R70.2
unnamed: Q9.1, QB9.1, R71.2
unnamed: Q10.1, QB10.1, R72.2
unnamed: Q11.1, QB11.1, R73.2
unnamed: Q12.1, QB12.1, R74.2
unnamed: Q13.1, QB13.1, R75.2
unnamed: Q14.1, QB14.1, R76.2
unnamed: Q15.1, QB15.1, R77.2
unnamed: Q16.1, QB16.1, R78.2
unnamed: Q17.1, QB17.1, R79.2
unnamed: Q18.1, QB18.1, R80.2
unnamed: Q19.1, QB19.1, R81.2
unnamed: Q20.1, QB20.1, R82.2
unnamed: Q21.1, QB21.1, R83.2
unnamed: Q22.1, QB22.1, R84.2
unnamed: Q23.1, QB23.1, R85.2
unnamed: Q24.1, QB24.1, R86.2
unnamed: R10.2, U3.3
unnamed: R52.2, U4.3
VbankA: D26.2, D29.1, D32.1, D35.1, D38.1, D41.1, D44.1, D47.1, D50.1, F1.1, J6.6, J13.3
VbankB: D27.2, D30.1, D33.1, D36.1, D39.1, D42.1, D45.1, D48.1, D51.1, F2.1, J7.5, J13.2
VbankC: D28.2, D31.1, D34.1, D37.1, D40.1, D43.1, D46.1, D49.1, D52.1, F3.1, J8.4, J13.1
