cobra18t/CobraPin/(commit log)

2021-08-28 Add KiCad source files
    [CobraPin_v1_00.kicad_pcb, CobraPin_v1_00.sch, Neopixel.sch, PWR.sch, SOLENOID.sch]
2021-09-27 Added note showing that this is specific to the Xpansion board
2022-01-21 add pdf schematic
2024-08-30 Add satellite board dimension pdf
2024-09-20 Add STM32 pin mapping
2024-09-20 Add Xpansion schematic
2024-11-23 Add Board0 config with servos on 0-0-10 and 0-0-11
2025-04-22 Add config for Satellite with servos enabled
2025-06-26 Added Board 1 Direct, Servos, No glow
2025-06-28 Add Xpansion board source
2026-05-30 Add MiniProto files
    [3bankTarget.3mf, MiniProto3_layout.DXF, Post.3MF, TallTargetHolder.3MF, drainGuidePickup.3mf, orbitAndLoop.3MF, target.3MF, targetTaller.3MF]
2026-06-26 Add option for standard board 0 with servo on 11
